junfrankli/Team-Shrimp-Cracker/images/adam.jpg

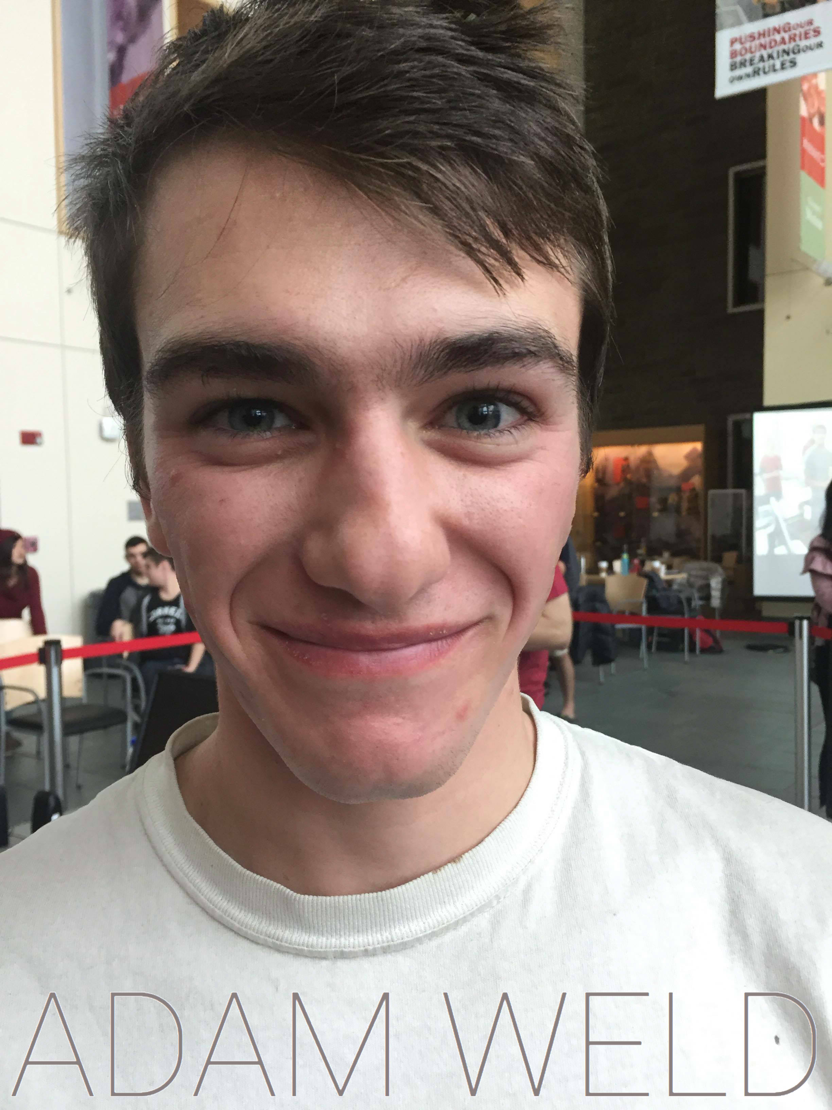
images/adam.jpg
