junfrankli/Team-Shrimp-Cracker/images/shrimpbot-3.jpg

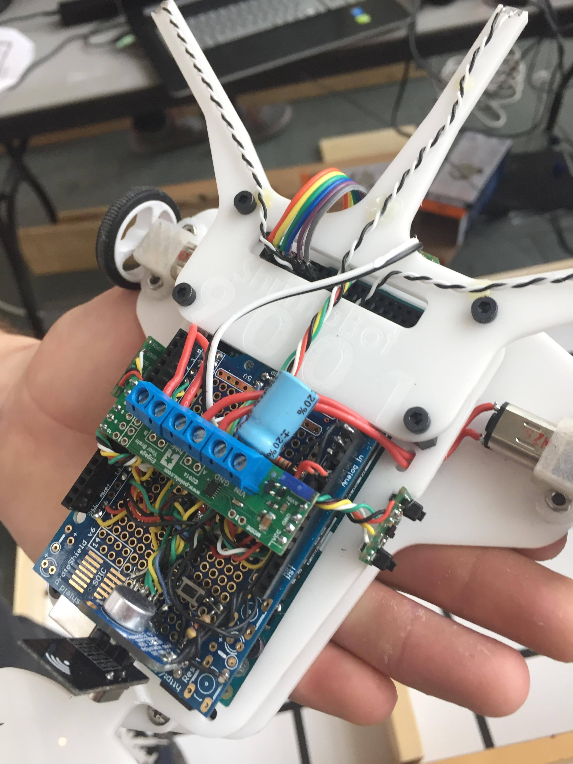
images/shrimpbot-3.jpg
