junfrankli/Team-Shrimp-Cracker/README.md

## Meet Shrimpy

Inspired by the delicious snack that holds so much flavor in such a small size, Shrimpy is intended to be a fully autonomous robot capable of traversing and mapping a maze.

Team Shrimpy's Website can be found here: 
http://shrimper.life/
