junfrankli/Team-Shrimp-Cracker/index.md

# Meet Shrimpy

Inspired by the delicious snack that holds so much flavor in such a small size, Shrimpy is intended to be a fully autonomous robot capable of traversing and mapping a maze.

# [Lab 1: Microcontrollers](lab1.md)
Running Robot in Square

# [Lab 2: Analog Circuitry and FFT](lab2.md)


# [Lab 3: FPGA Video Controller and Sound Generation](lab3.md)


# [Lab 4: Radio Communication and Map Drawing](lab4.md)

# [Milestone 1](milestone1.md)


# [Milestone 2](milestone2.md)
Treasure detection

# [Milestone 3](milestone3.md)
deeeeemo (https://l.facebook.com/l.php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)

# [Milestone 4](Milestone%204_%20Integrating%20Everything.md)

# [Team Contract](teamcontract.md)

# [Meeting Notes](meetings.md)

# [Ethics Case Study](ethics.docx)
