junfrankli/Team-Shrimp-Cracker/images/boyi.jpg

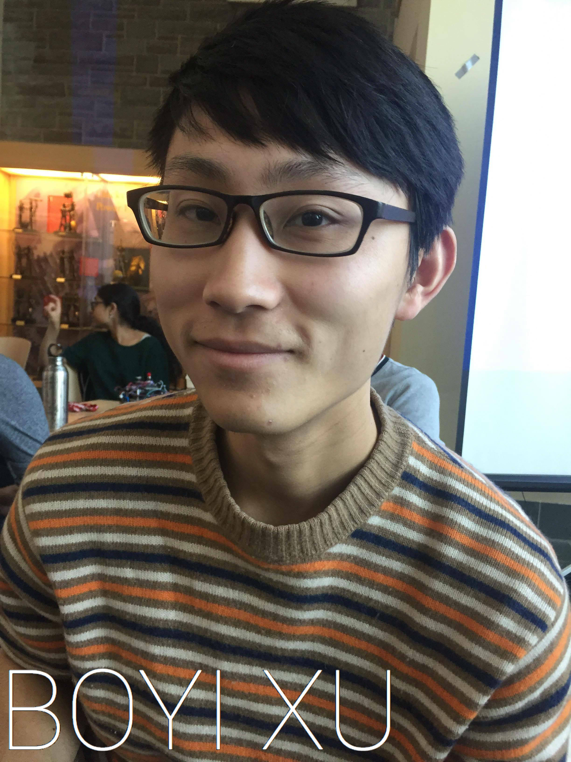
images/boyi.jpg
