junfrankli/Team-Shrimp-Cracker/images/dfs_vs_bfs.gif

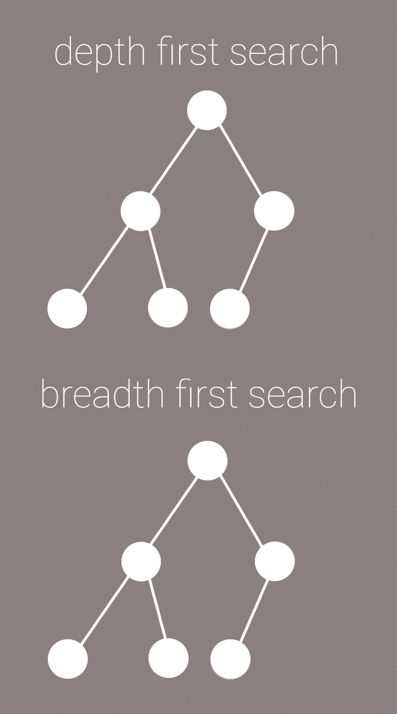
images/dfs_vs_bfs.gif
