junfrankli/Team-Shrimp-Cracker/images/final.png

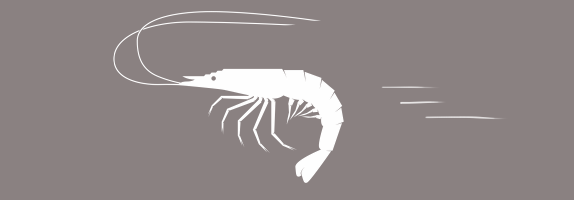
images/final.png
