junfrankli/Team-Shrimp-Cracker/images/frank.jpg

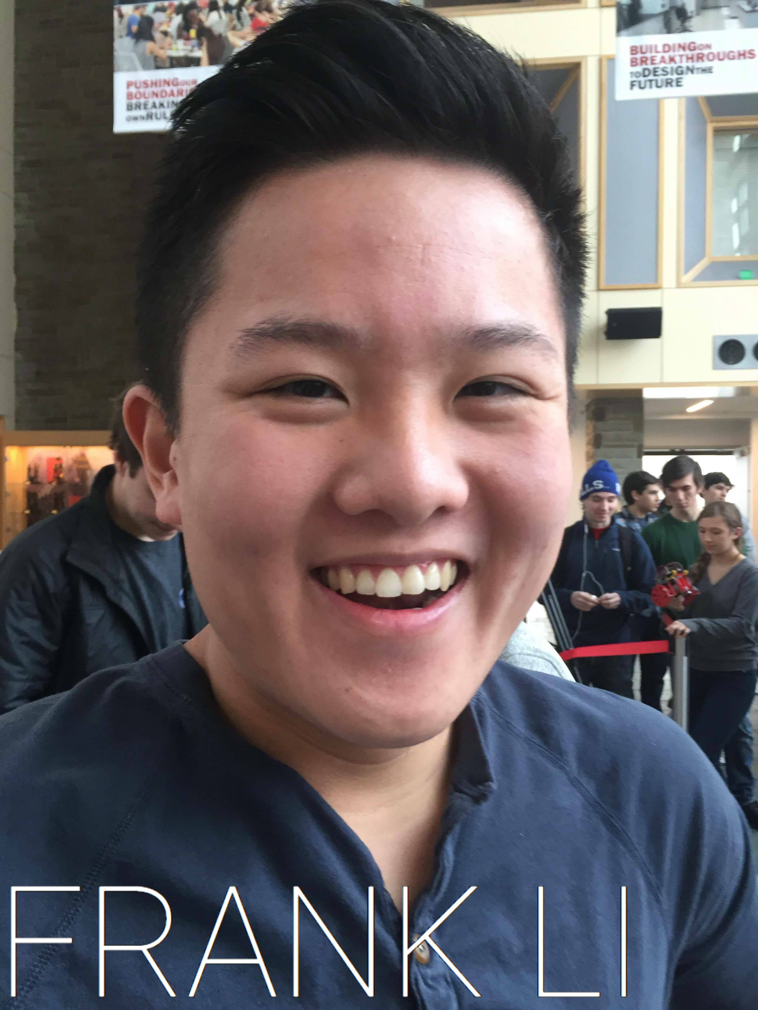
images/frank.jpg
