junfrankli/Team-Shrimp-Cracker/images/header2.png

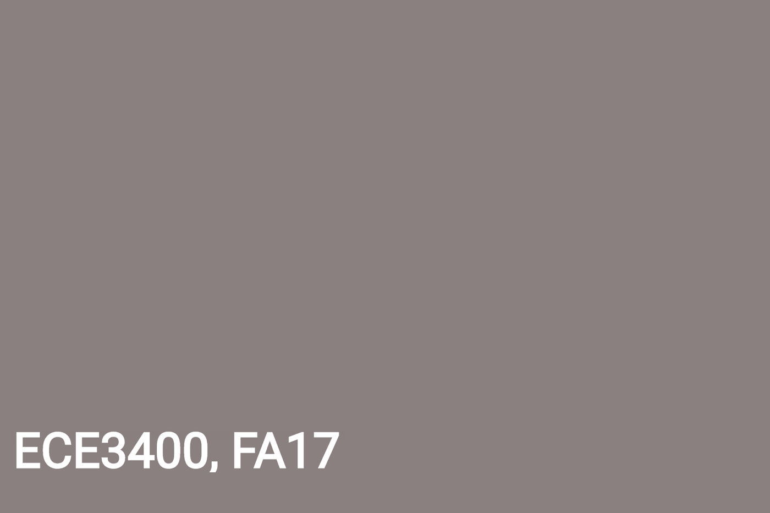
images/header2.png
