junfrankli/Team-Shrimp-Cracker/images/header.png

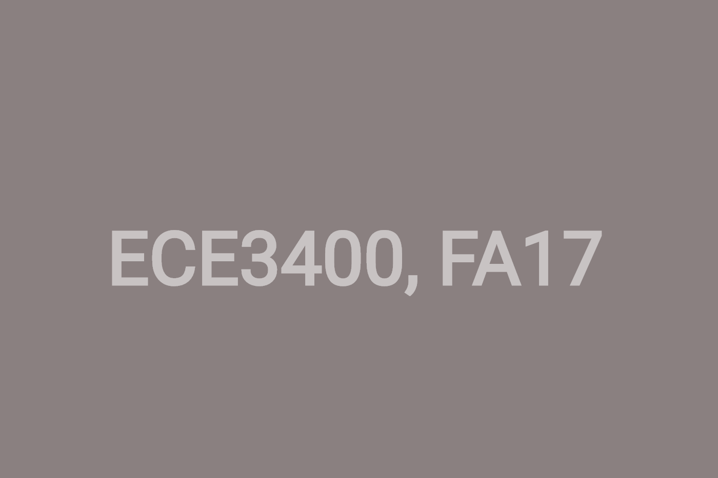
images/header.png
