junfrankli/Team-Shrimp-Cracker/images/lab01.png

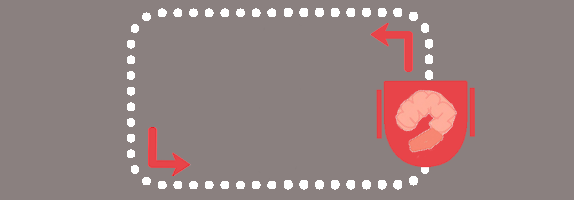
images/lab01.png
