junfrankli/Team-Shrimp-Cracker/images/lab02.png

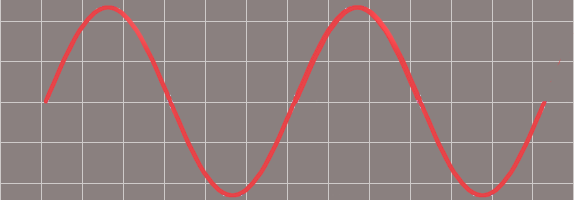
images/lab02.png
