junfrankli/Team-Shrimp-Cracker/images/lab02_circuitry2.png

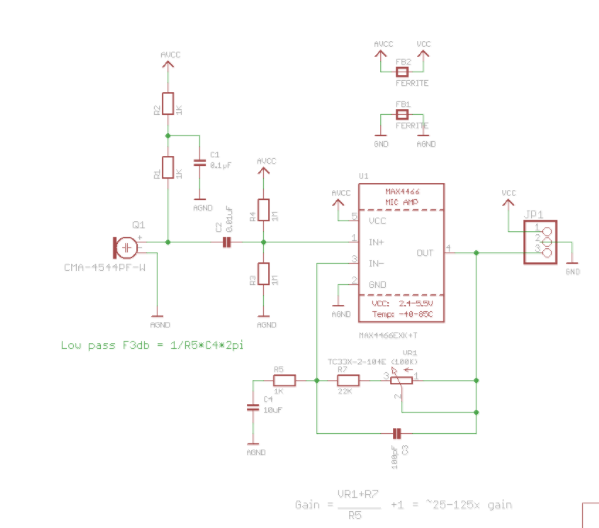
images/lab02_circuitry2.png
