junfrankli/Team-Shrimp-Cracker/images/lab02_circuitry3.png

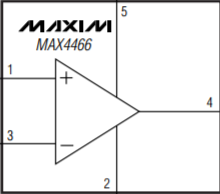
images/lab02_circuitry3.png
