junfrankli/Team-Shrimp-Cracker/images/lab02_circuitry.png

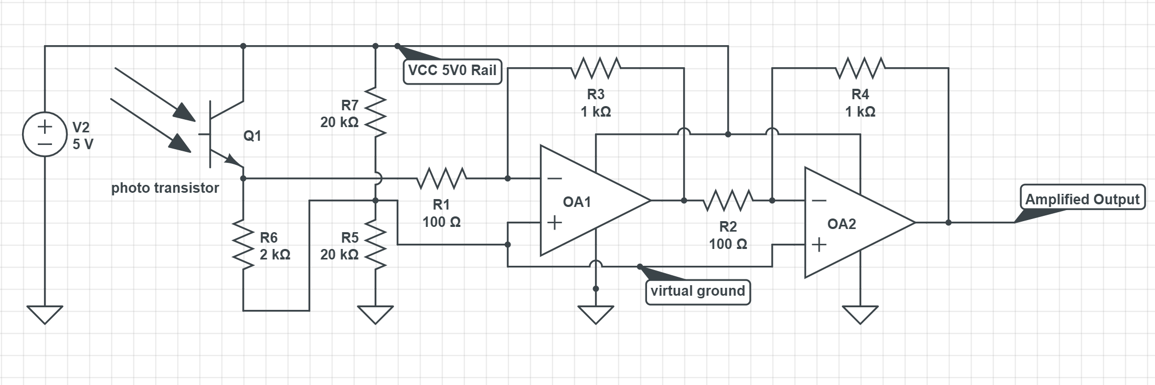
images/lab02_circuitry.png
