junfrankli/Team-Shrimp-Cracker/images/lab02_graph2.png

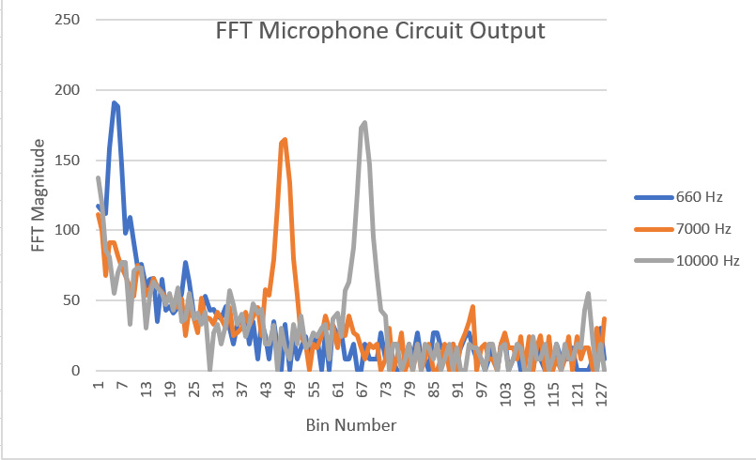
images/lab02_graph2.png
