junfrankli/Team-Shrimp-Cracker/images/lab02_graph3.png

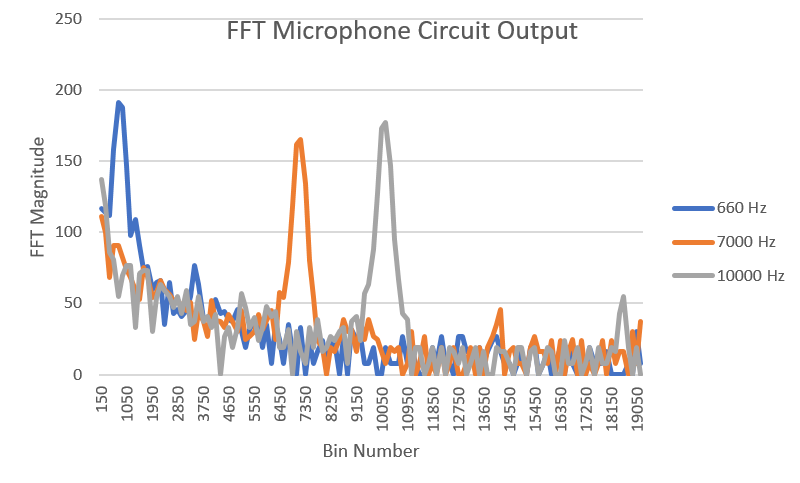
images/lab02_graph3.png
