junfrankli/Team-Shrimp-Cracker/images/lab02_graph.png

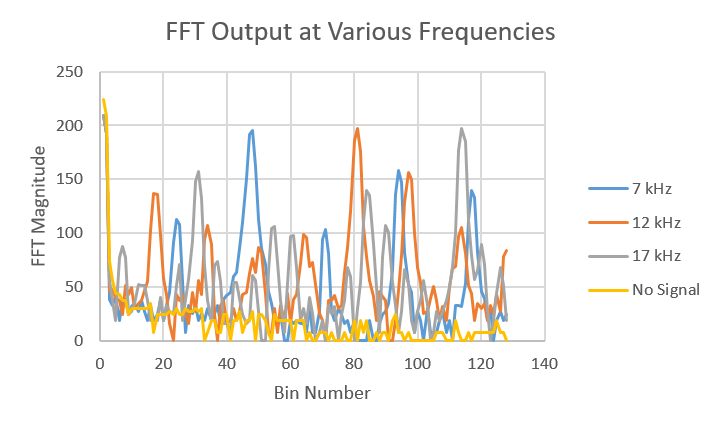
images/lab02_graph.png
