junfrankli/Team-Shrimp-Cracker/images/lab02_prelab2.jpg

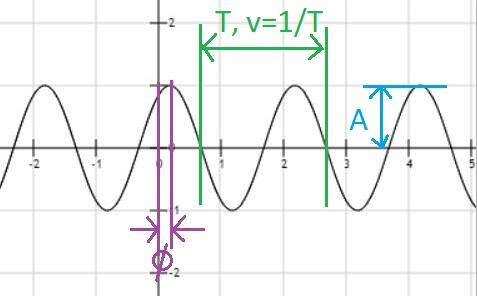
images/lab02_prelab2.jpg
