junfrankli/Team-Shrimp-Cracker/images/lab03.gif

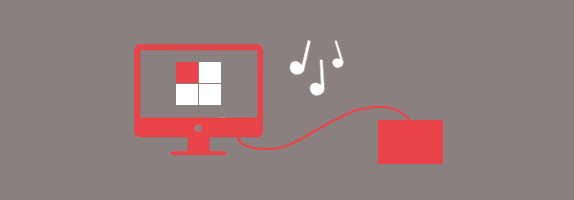
images/lab03.gif
