junfrankli/Team-Shrimp-Cracker/images/lab04.gif

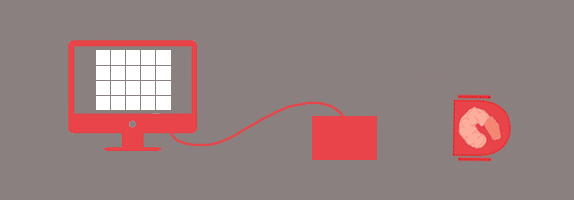
images/lab04.gif
