junfrankli/Team-Shrimp-Cracker/images/m01.png

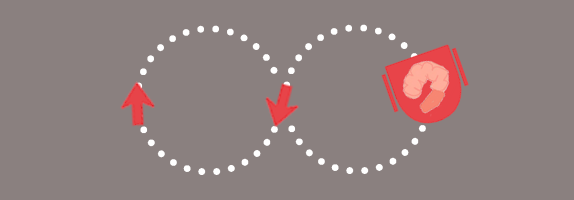
images/m01.png
