junfrankli/Team-Shrimp-Cracker/images/m01_diagram.png

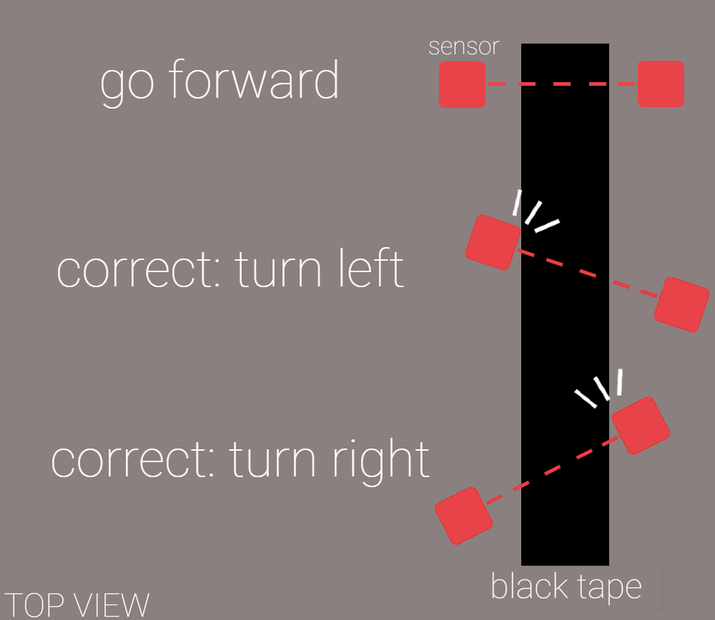
images/m01_diagram.png
