junfrankli/Team-Shrimp-Cracker/images/m02.gif

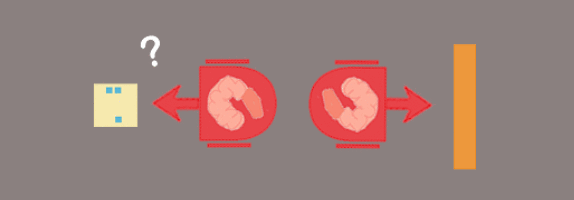
images/m02.gif
