junfrankli/Team-Shrimp-Cracker/images/m03-stuff.png

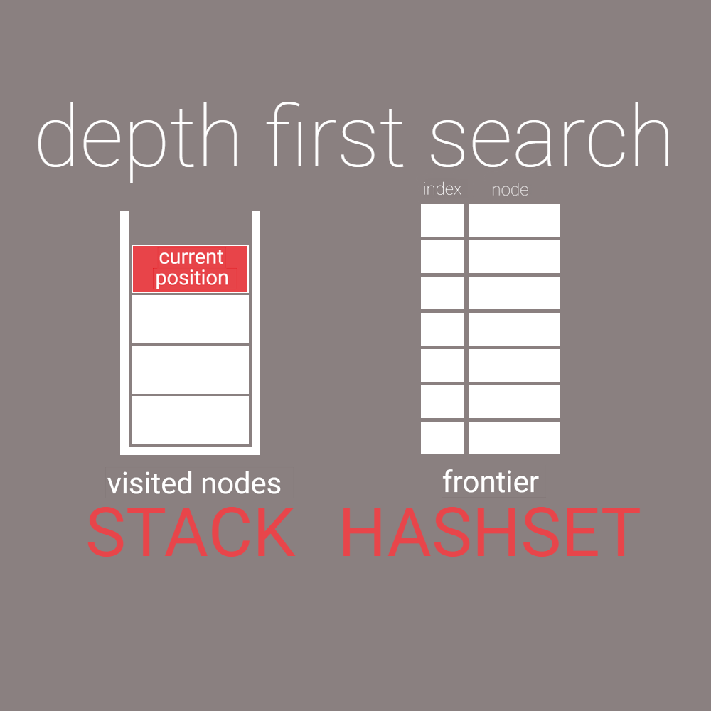
images/m03-stuff.png
