junfrankli/Team-Shrimp-Cracker/images/m03.gif

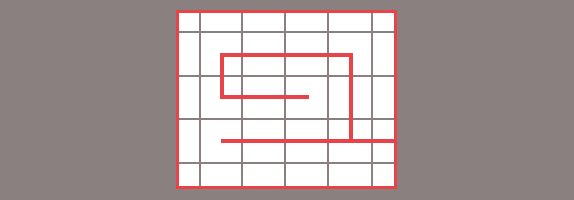
images/m03.gif
