junfrankli/Team-Shrimp-Cracker/images/malavika.jpg

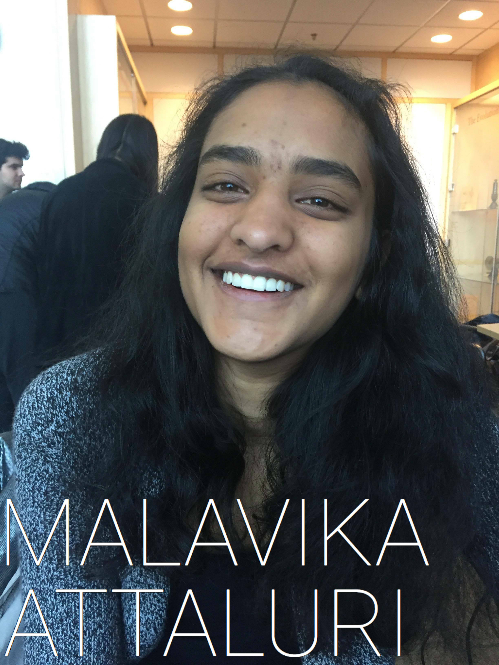
images/malavika.jpg
