junfrankli/Team-Shrimp-Cracker/images/shirley.png

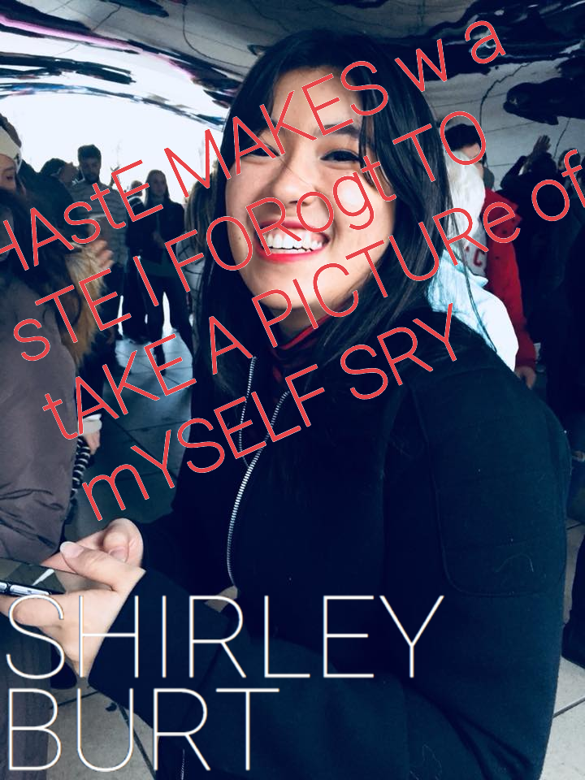
images/shirley.png
