junfrankli/Team-Shrimp-Cracker/images/shrimpbot9001 (2).jpg

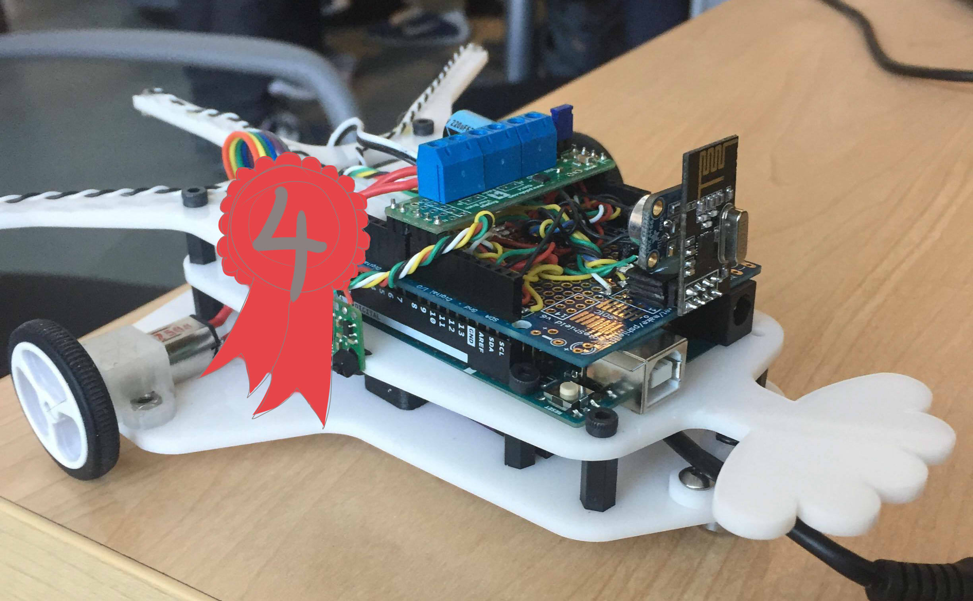
images/shrimpbot9001 (2).jpg
