junfrankli/Team-Shrimp-Cracker/images/shrimpbot-1.jpg

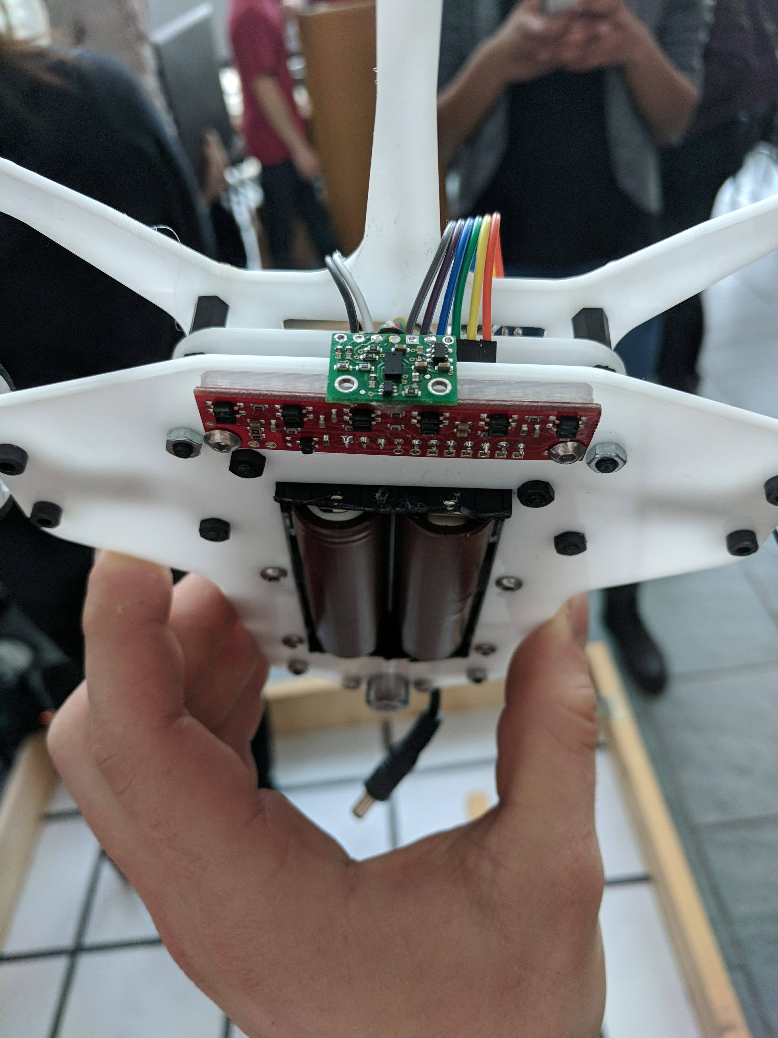
images/shrimpbot-1.jpg
