junfrankli/Team-Shrimp-Cracker/images/shrimpbot-2.jpg

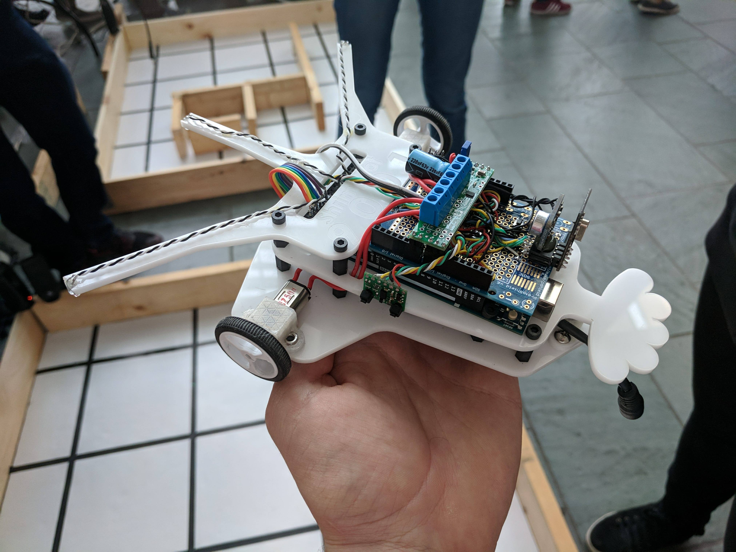
images/shrimpbot-2.jpg
