junfrankli/Team-Shrimp-Cracker/images/shrimpbot-4.jpg

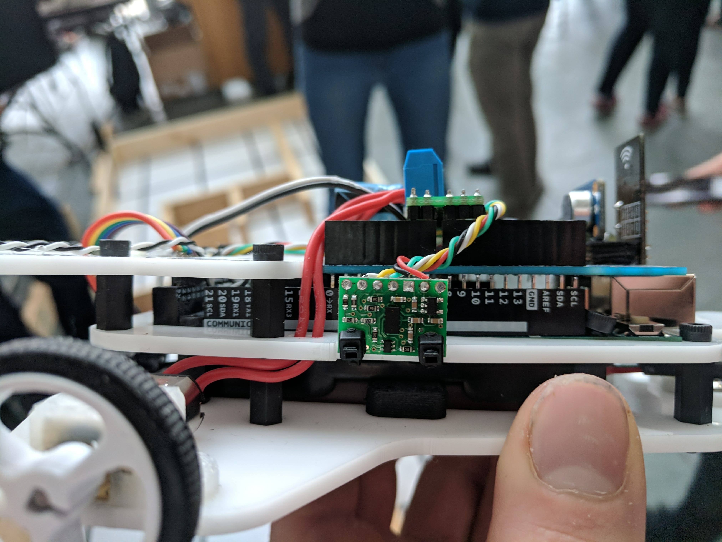
images/shrimpbot-4.jpg
