junfrankli/Team-Shrimp-Cracker/images/shrimpers.jpg

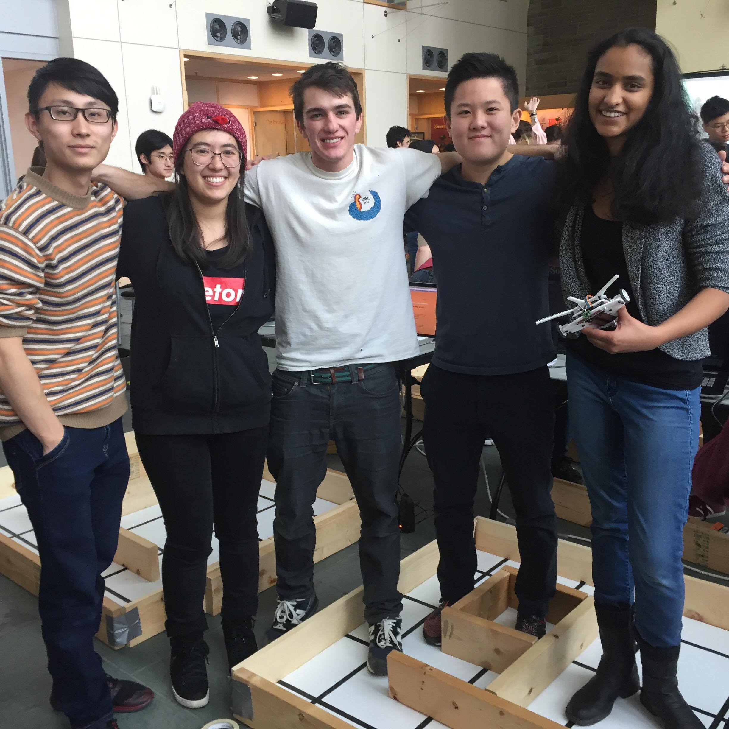
images/shrimpers.jpg
