junfrankli/Team-Shrimp-Cracker/images/BOM.PNG

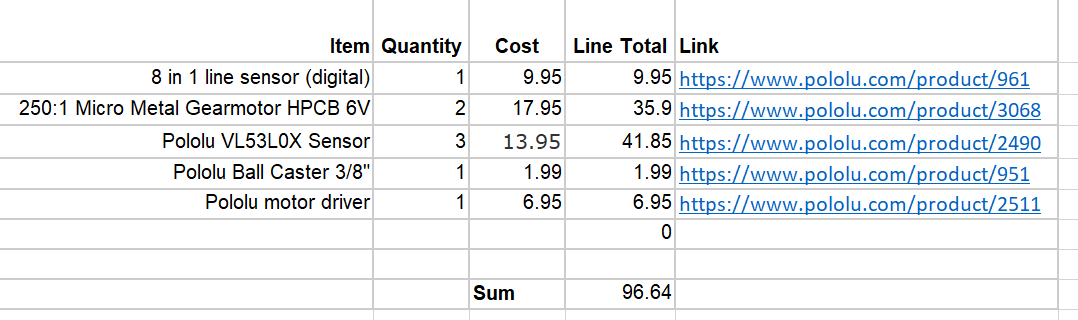
images/BOM.PNG
