junfrankli/Team-Shrimp-Cracker/code/SINE_WAVE.v

// Quartus II Verilog Template
// Single Port ROM

module SINE_WAVE
(
   input [7:0] ADDR_VALUE,
	input CLOCK,
	output reg [7:0] SINE_OUT
);

	reg [7:0] sine[255:0];
    
	initial
	begin
		sine[0] <= 8'b10000010;
		sine[1] <= 8'b10000101;
		sine[2] <= 8'b10001000;
		sine[3] <= 8'b10001011;
		sine[4] <= 8'b10001111;
		sine[5] <= 8'b10010010;
		sine[6] <= 8'b10010101;
		sine[7] <= 8'b10011000;
		sine[8] <= 8'b10011011;
		sine[9] <= 8'b10011110;
		sine[10] <= 8'b10100001;
		sine[11] <= 8'b10100100;
		sine[12] <= 8'b10100111;
		sine[13] <= 8'b10101010;
		sine[14] <= 8'b10101101;
		sine[15] <= 8'b10110000;
		sine[16] <= 8'b10110011;
		sine[17] <= 8'b10110110;
		sine[18] <= 8'b10111000;
		sine[19] <= 8'b10111011;
		sine[20] <= 8'b10111110;
		sine[21] <= 8'b11000001;
		sine[22] <= 8'b11000011;
		sine[23] <= 8'b11000110;
		sine[24] <= 8'b11001000;
		sine[25] <= 8'b11001011;
		sine[26] <= 8'b11001101;
		sine[27] <= 8'b11010000;
		sine[28] <= 8'b11010010;
		sine[29] <= 8'b11010101;
		sine[30] <= 8'b11010111;
		sine[31] <= 8'b11011001;
		sine[32] <= 8'b11011011;
		sine[33] <= 8'b11011101;
		sine[34] <= 8'b11100000;
		sine[35] <= 8'b11100010;
		sine[36] <= 8'b11100100;
		sine[37] <= 8'b11100101;
		sine[38] <= 8'b11100111;
		sine[39] <= 8'b11101001;
		sine[40] <= 8'b11101011;
		sine[41] <= 8'b11101100;
		sine[42] <= 8'b11101110;
		sine[43] <= 8'b11101111;
		sine[44] <= 8'b11110001;
		sine[45] <= 8'b11110010;
		sine[46] <= 8'b11110100;
		sine[47] <= 8'b11110101;
		sine[48] <= 8'b11110110;
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
		sine[249] <= 8'b01101100;
		sine[250] <= 8'b01101111;
		sine[251] <= 8'b01110011;
		sine[252] <= 8'b01110110;
		sine[253] <= 8'b01111001;
		sine[254] <= 8'b01111100;
		sine[255] <= 8'b01111111;
	end


  always @ (posedge CLOCK)
  begin
    SINE_OUT <= sine[ADDR_VALUE];
  end

endmodule
