junfrankli/Team-Shrimp-Cracker/FPGA/SINE_WAVE.v

// Quartus II Verilog Template
// Single Port ROM

module SINE_WAVE
(
   input [7:0] ADDR_VALUE,
	input CLOCK,
	output reg [7:0] SINE_OUT
);

	reg [7:0] sine[255:0];
    
	initial
	begin
		sine[0] <= 8'b10000000;
sine[1] <= 8'b10000011;
sine[2] <= 8'b10000110;
sine[3] <= 8'b10001001;
sine[4] <= 8'b10001100;
sine[5] <= 8'b10001111;
sine[6] <= 8'b10010010;
sine[7] <= 8'b10010101;
sine[8] <= 8'b10011001;
sine[9] <= 8'b10011100;
sine[10] <= 8'b10011111;
sine[11] <= 8'b10100010;
sine[12] <= 8'b10100101;
sine[13] <= 8'b10101000;
sine[14] <= 8'b10101011;
sine[15] <= 8'b10101110;
sine[16] <= 8'b10110001;
sine[17] <= 8'b10110100;
sine[18] <= 8'b10110110;
sine[19] <= 8'b10111001;
sine[20] <= 8'b10111100;
sine[21] <= 8'b10111111;
sine[22] <= 8'b11000010;
sine[23] <= 8'b11000100;
sine[24] <= 8'b11000111;
sine[25] <= 8'b11001001;
sine[26] <= 8'b11001100;
sine[27] <= 8'b11001111;
sine[28] <= 8'b11010001;
sine[29] <= 8'b11010011;
sine[30] <= 8'b11010110;
sine[31] <= 8'b11011000;
sine[32] <= 8'b11011010;
sine[33] <= 8'b11011100;
sine[34] <= 8'b11011111;
sine[35] <= 8'b11100001;
sine[36] <= 8'b11100011;
sine[37] <= 8'b11100101;
sine[38] <= 8'b11100111;
sine[39] <= 8'b11101000;
sine[40] <= 8'b11101010;
sine[41] <= 8'b11101100;
sine[42] <= 8'b11101110;
sine[43] <= 8'b11101111;
sine[44] <= 8'b11110001;
sine[45] <= 8'b11110010;
sine[46] <= 8'b11110011;
sine[47] <= 8'b11110101;
sine[48] <= 8'b11110110;
sine[49] <= 8'b11110111;
sine[50] <= 8'b11111000;
sine[51] <= 8'b11111001;
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
sine[216] <= 8'b00010111;
sine[217] <= 8'b00011000;
sine[218] <= 8'b00011010;
sine[219] <= 8'b00011100;
sine[220] <= 8'b00011110;
sine[221] <= 8'b00100000;
sine[222] <= 8'b00100011;
sine[223] <= 8'b00100101;
sine[224] <= 8'b00100111;
sine[225] <= 8'b00101001;
sine[226] <= 8'b00101100;
sine[227] <= 8'b00101110;
sine[228] <= 8'b00110000;
sine[229] <= 8'b00110011;
sine[230] <= 8'b00110110;
sine[231] <= 8'b00111000;
sine[232] <= 8'b00111011;
sine[233] <= 8'b00111101;
sine[234] <= 8'b01000000;
sine[235] <= 8'b01000011;
sine[236] <= 8'b01000110;
sine[237] <= 8'b01001001;
sine[238] <= 8'b01001011;
sine[239] <= 8'b01001110;
sine[240] <= 8'b01010001;
sine[241] <= 8'b01010100;
sine[242] <= 8'b01010111;
sine[243] <= 8'b01011010;
sine[244] <= 8'b01011101;
sine[245] <= 8'b01100000;
sine[246] <= 8'b01100011;
sine[247] <= 8'b01100110;
sine[248] <= 8'b01101010;
sine[249] <= 8'b01101101;
sine[250] <= 8'b01110000;
sine[251] <= 8'b01110011;
sine[252] <= 8'b01110110;
sine[253] <= 8'b01111001;
sine[254] <= 8'b01111100;
sine[255] <= 8'b10000000;
	end


  always @ (posedge CLOCK)
  begin
    SINE_OUT <= sine[ADDR_VALUE];
  end

endmodule
