junfrankli/Team-Shrimp-Cracker/(commit log)

2017-11-16 dist sensors
2017-11-20 fixed a bug in DFS
    [DFS.ino]
